olegv142/GsmMon/README.md

# GsmMon
GSM home monitor

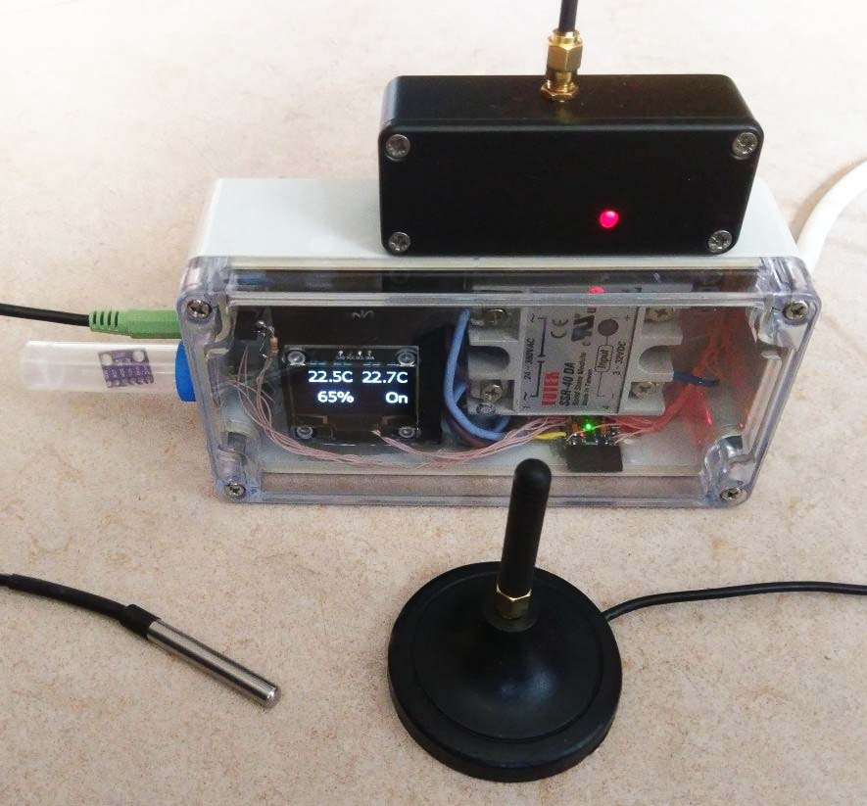
[picture p1: doc/GsmMon.jpg]
GSM Home monitor


This device is designed to monitor and report via SMS the temperature and humidity inside the home
and be able to turn on/off some AC powered equipment (e.g. the heater) on receiving SMS from remote operator.
The are 2 temperature channels with the optional second one designed to monitor the water temperature in
the home heating system.

The SMS message sent by operator always starts from the # symbol.
It may be followed by the following tokens separated by the space or comma:
```
  1        turn on  AC switch
  0        turn off AC switch
  /n       set reporting interval to n hours
  p<PIN>   authenticate with <PIN>
  P<PIN>   set new <PIN>
```
The response will be sent to any authenticated message, even the empty one
(consisting from the single # symbol).
The sender is authenticated implicitly unless the PIN is set and the sender address differs
from the address used previously. In such case the new sender should provide PIN in order
to be authenticated.

The SMS sent back as the response will contain the current AC switch state (as 0 or 1),
temperature and humidity readings, reporting interval and GSM network signal quality metric.

The controller being used is Arduino pro mini 3.3v 8MHz (ATMega328). The full connection diagram is shown below:

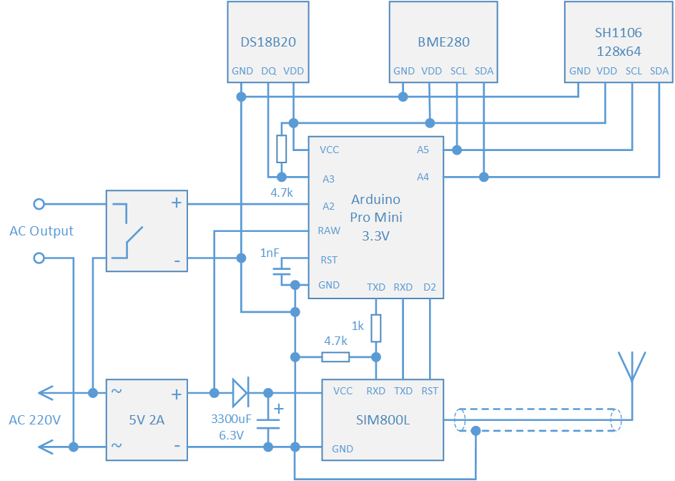
[picture p2: doc/GsmMon.png]
GSM Home monitor schematic


To reduce EMI the GSM radio module is placed in the separate metal box as seen on the following figure.

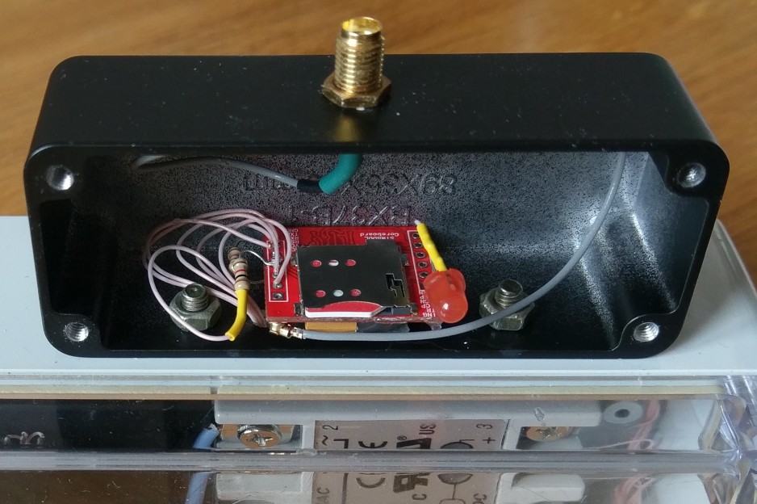
[picture p3: doc/radio.jpg]
Radio module housing


Using external antenna separated from the device is absolutely necessary to avoid destructive EMI from the radio module.
Otherwise its transmission bursts are able to cause Arduino resetting. The distance from the device to antenna 
(and so the cable length) should be long enough in comparison to the radio carrier wavelength (~30 cm).
At least 1 meter of cable is recommended.

The sketch uses the following libraries:

[SimpleSIM](https://github.com/olegv142/SimpleSIM)

[Display](https://github.com/olegv142/Display)

[BME280](https://github.com/olegv142/BME280)

[DS18B20](https://github.com/olegv142/DS18B20)

[OneWire](https://github.com/olegv142/OneWire)

## Author

Oleg Volkov (olegv142@gmail.com)
