olegv142/GsmMon/doc/antenna.png

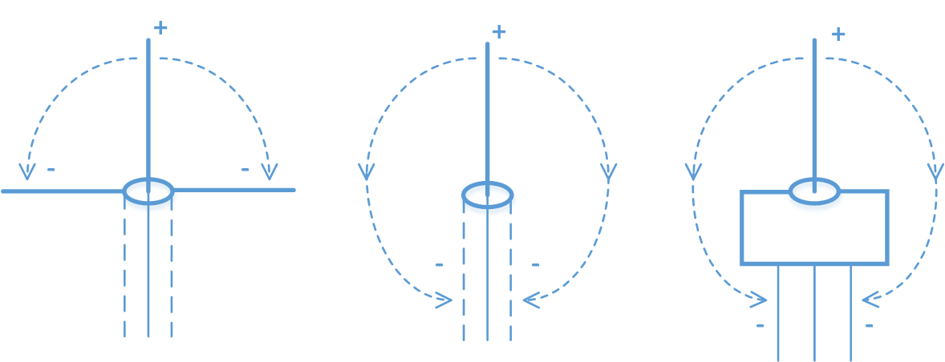
doc/antenna.png
