olegv142/GsmMon/(commit log)

2019-06-10 Avoid saving peer address in case it is already saved
    [GsmMon.ino]
2019-06-10 Avoid passing string by value in some cases
    [GsmMon.ino]
2019-06-20 Device photo added
2019-06-20 Device photo added to readme
2019-06-20 Schematic added
2019-07-19 Comment about external antenna is added to readme
2019-07-19 Arduino mini schematic
2019-07-20 Antenna EMI figures
2019-07-20 Antenna figures added
